uchan-nos/comproc/doc/signal-timing-design/cpu-mem-timing.png

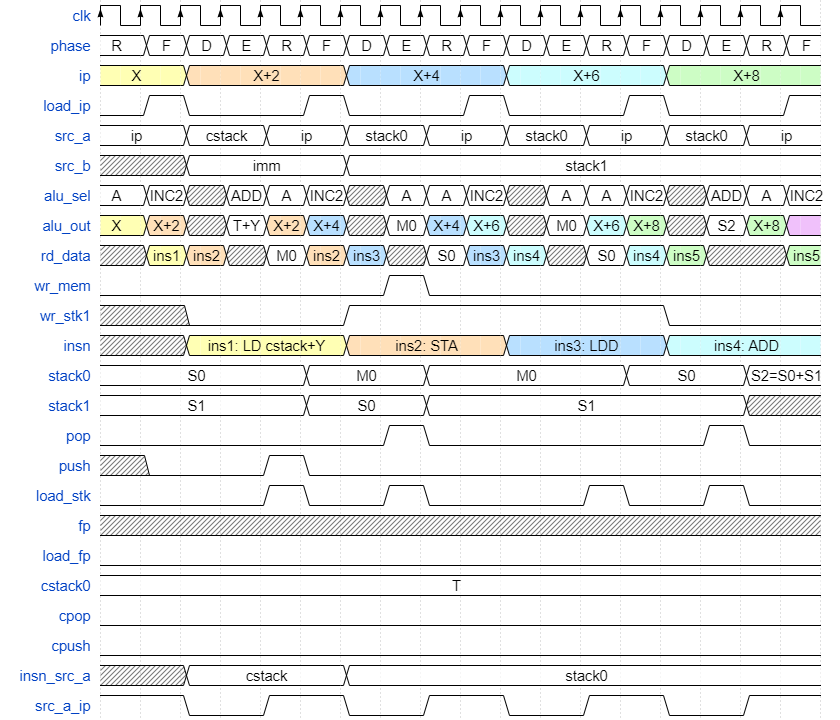
doc/signal-timing-design/cpu-mem-timing.png
