uchan-nos/comproc/doc/signal-timing-design/cpu-mem-timing_isr-int-iret.png

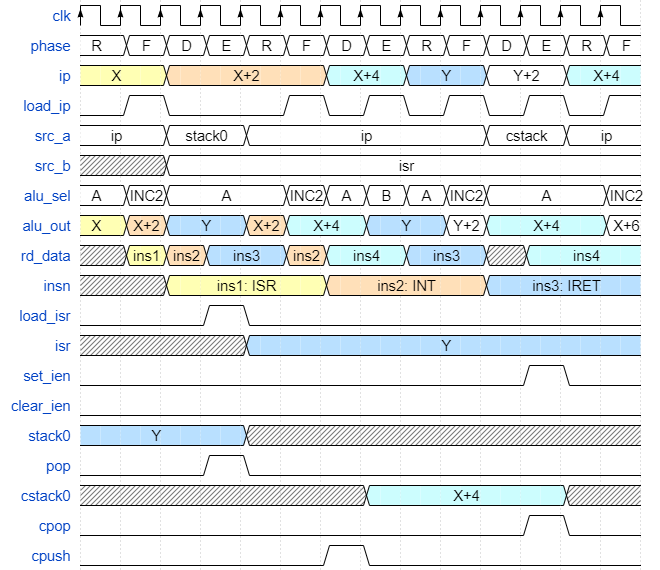
doc/signal-timing-design/cpu-mem-timing_isr-int-iret.png
