uchan-nos/comproc/doc/signal-timing-design/cpu-mem-timing_jmp-call-ret.png

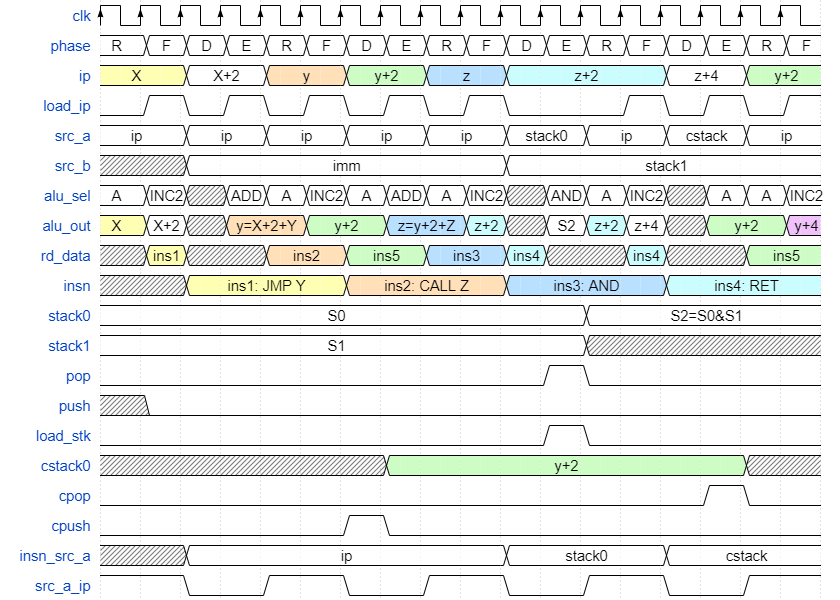
doc/signal-timing-design/cpu-mem-timing_jmp-call-ret.png
