uchan-nos/comproc/doc/signal-timing-design/cpu-mem-timing_jz-fp.png

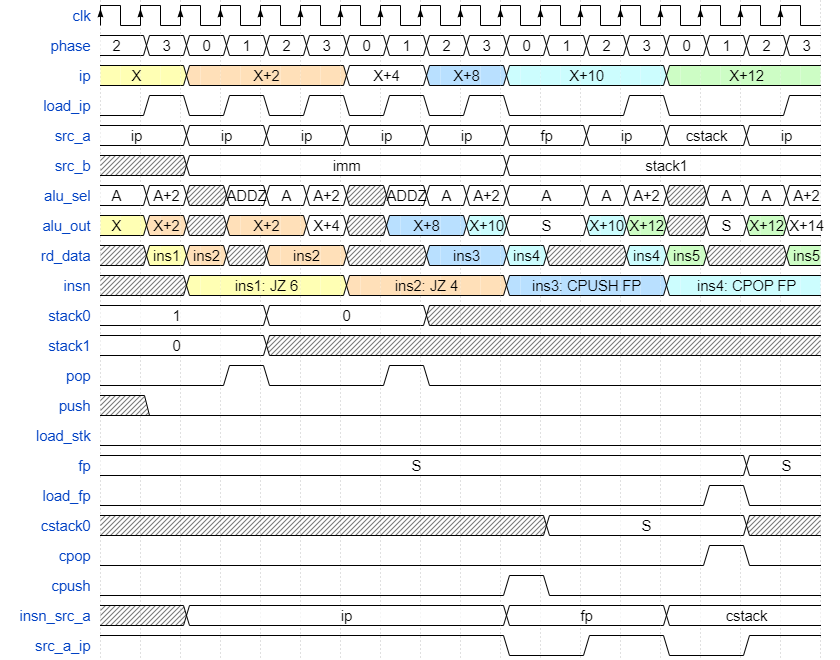
doc/signal-timing-design/cpu-mem-timing_jz-fp.png
