uchan-nos/comproc/doc/signal-timing-design/uart-mux-timing.png

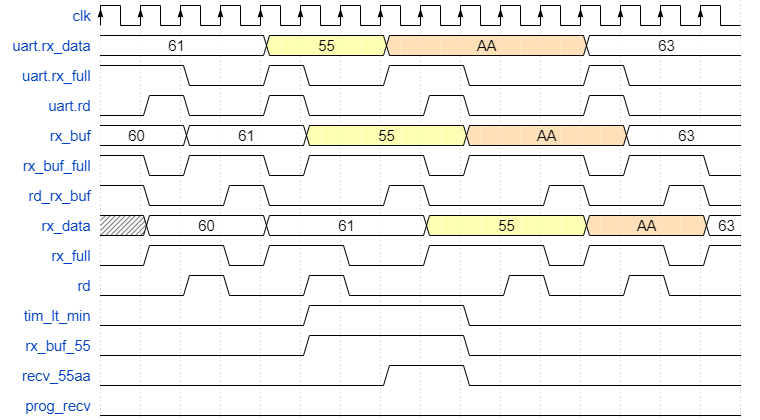
doc/signal-timing-design/uart-mux-timing.png
