uchan-nos/comproc/doc/signal-timing-design/uart-mux-timing_delimiter.png

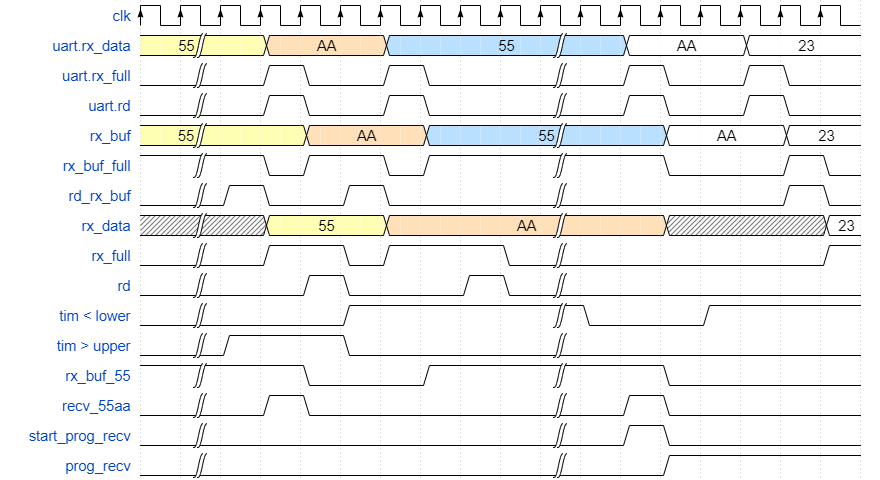
doc/signal-timing-design/uart-mux-timing_delimiter.png
