uchan-nos/comproc/doc/components-relationship.png

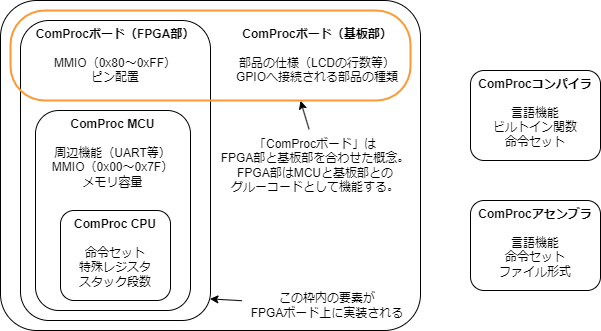
doc/components-relationship.png
