uchan-nos/comproc/doc/schematic/ComProcPC_rev1.pdf

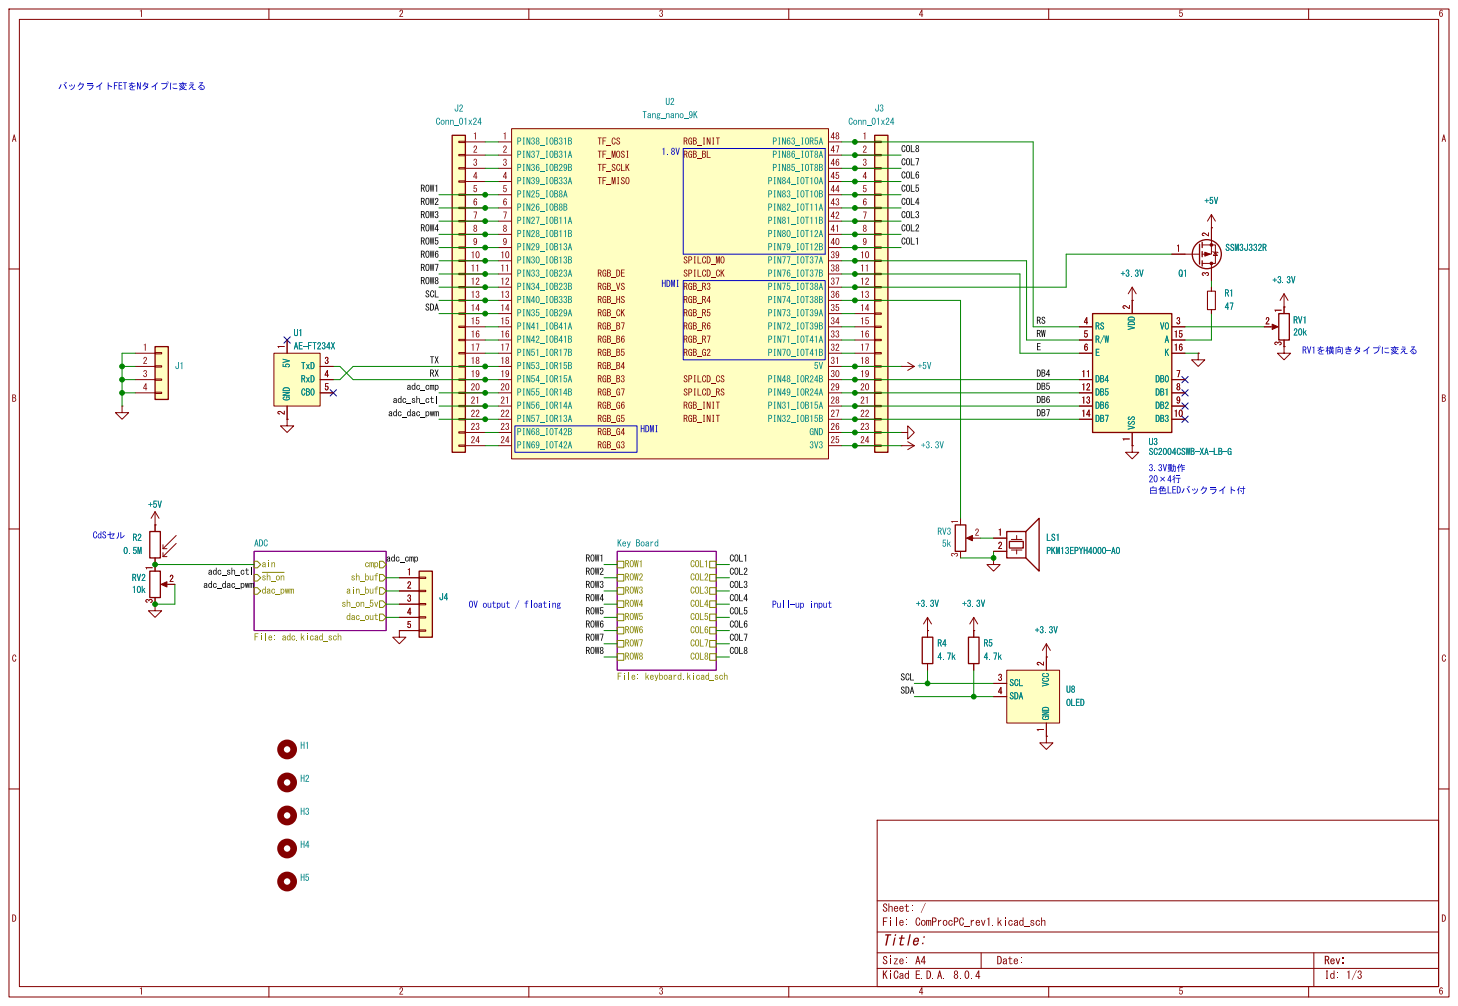
[picture p8: page 1]

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
Id: 1/3 Title: File: ComProcPC_rev1.kicad_sch Sheet: /

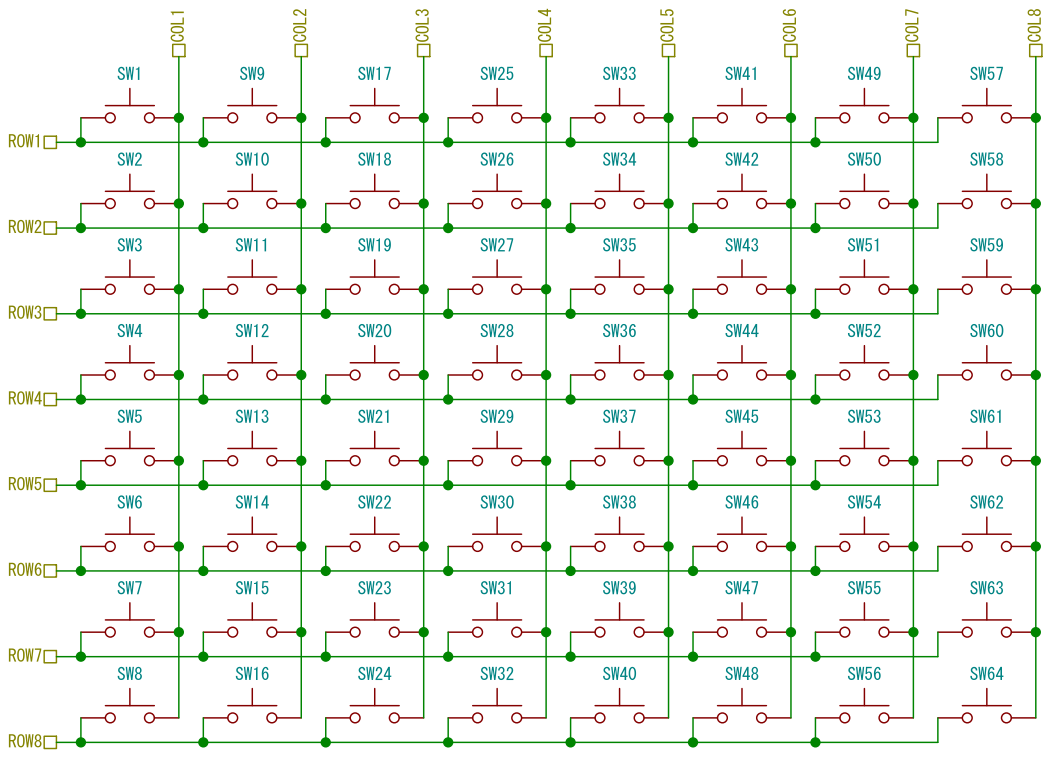
[picture p9: page 2]

Id: 2/3 Title: File: keyboard.kicad_sch Sheet: /Key Board/

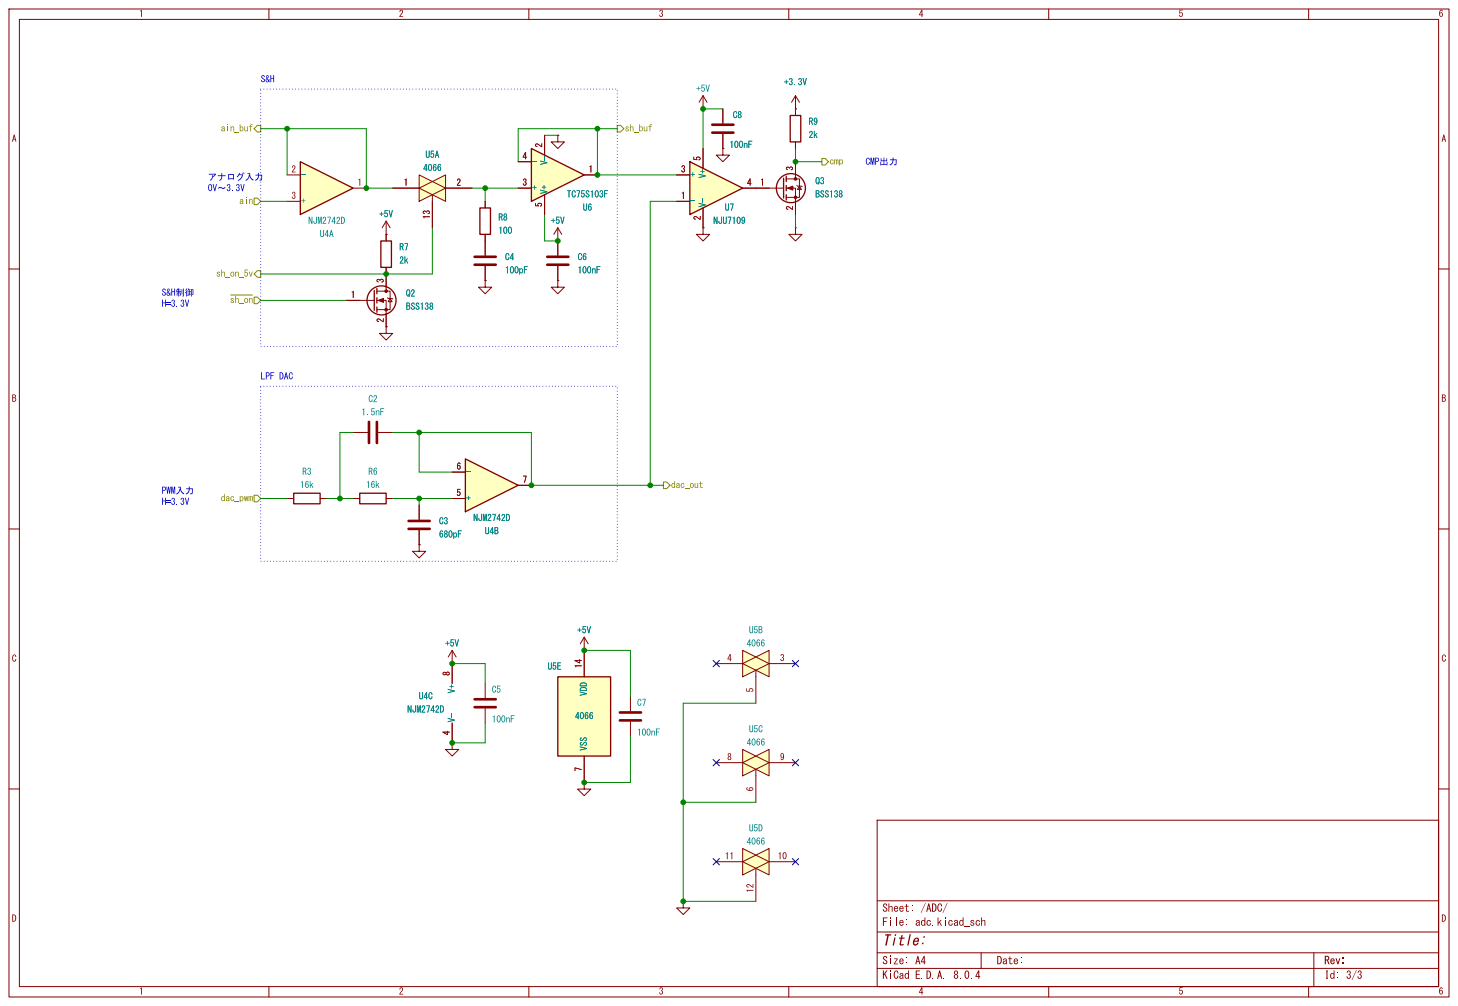
[picture p10: page 3]

Id: 3/3 Title: File: adc.kicad_sch Sheet: /ADC/
