uchan-nos/comproc/doc/schematic/ComProcBoard_rev4.pdf

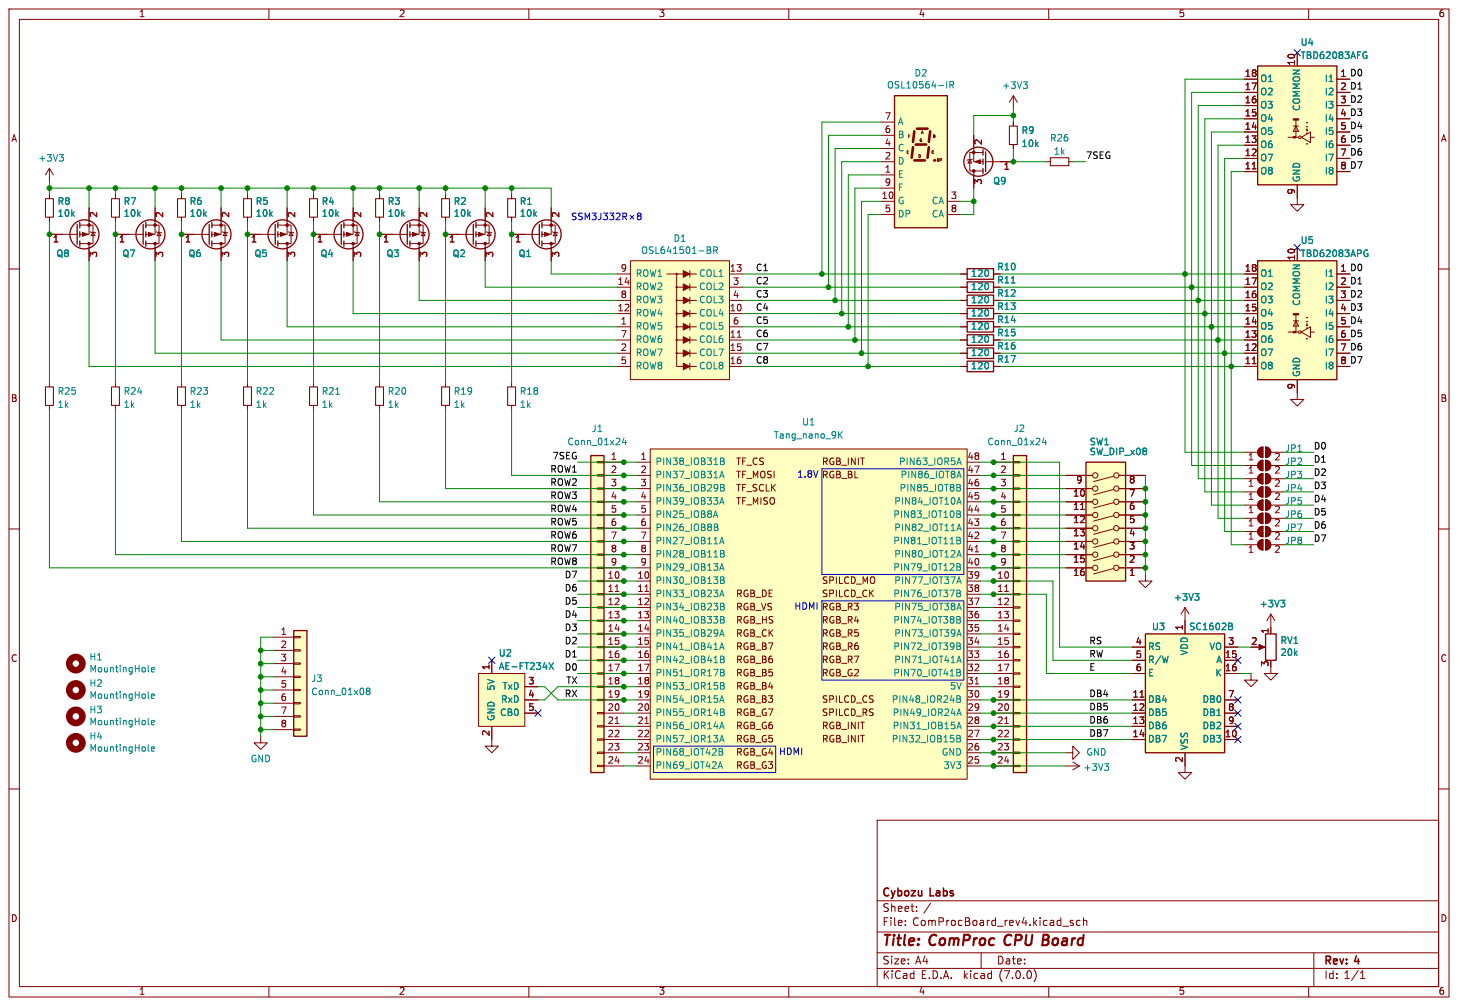
[picture p11: page 1]

Id: 1/1 Title: ComProc CPU Board
