uchan-nos/comproc/doc/datapath/datapath-diagram.pdf

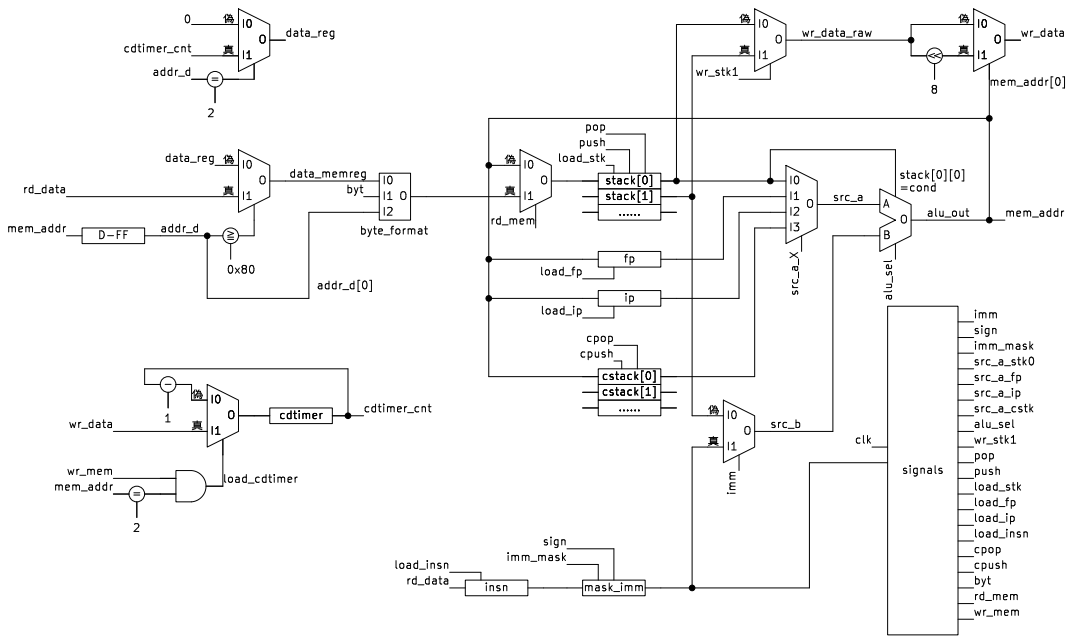
[picture p12: page 1]

cstack[0]
cstack[1]

Id: 1/1 Title: ComProc CPU þÿ0Ç0ü0¿0Ñ0¹ File: datapath-diagram.kicad_sch Sheet: / þÿGit0n0Ö0é0ó0Á main þÿ0k[þ_Ü0Y0‹0Ç0ü0¿0Ñ0¹Vó
