uchan-nos/comproc/doc/datapath/datapath-diagram_2377020c.pdf

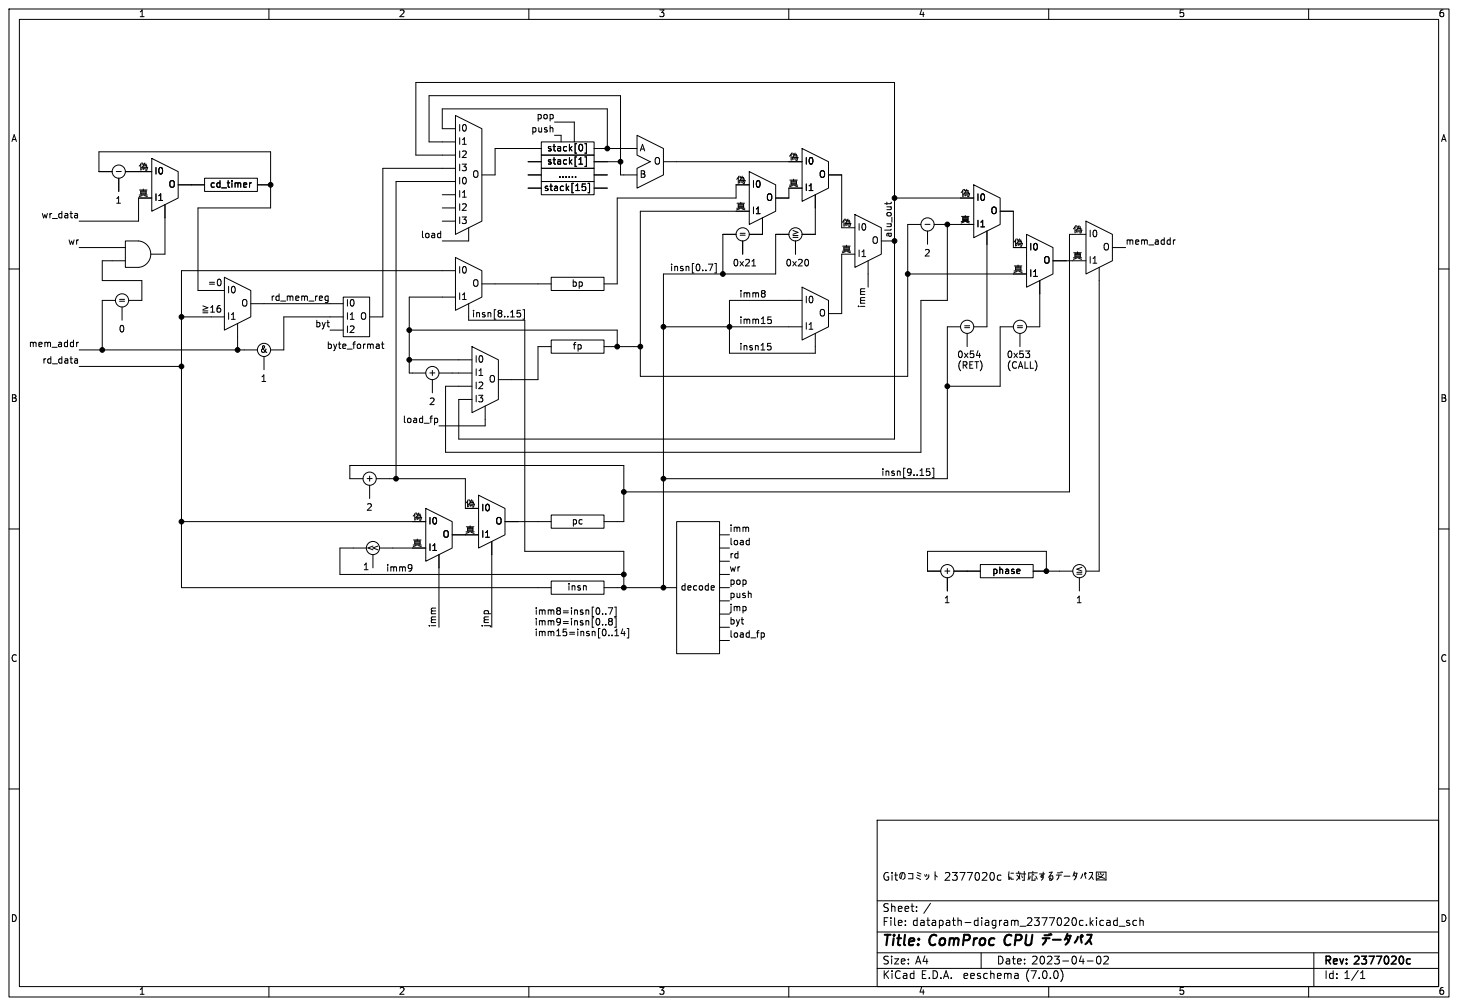
[picture p13: page 1]

stack[0]
stack[1]
