uchan-nos/comproc/doc/schematic/ComProcBoard_rev2.pdf

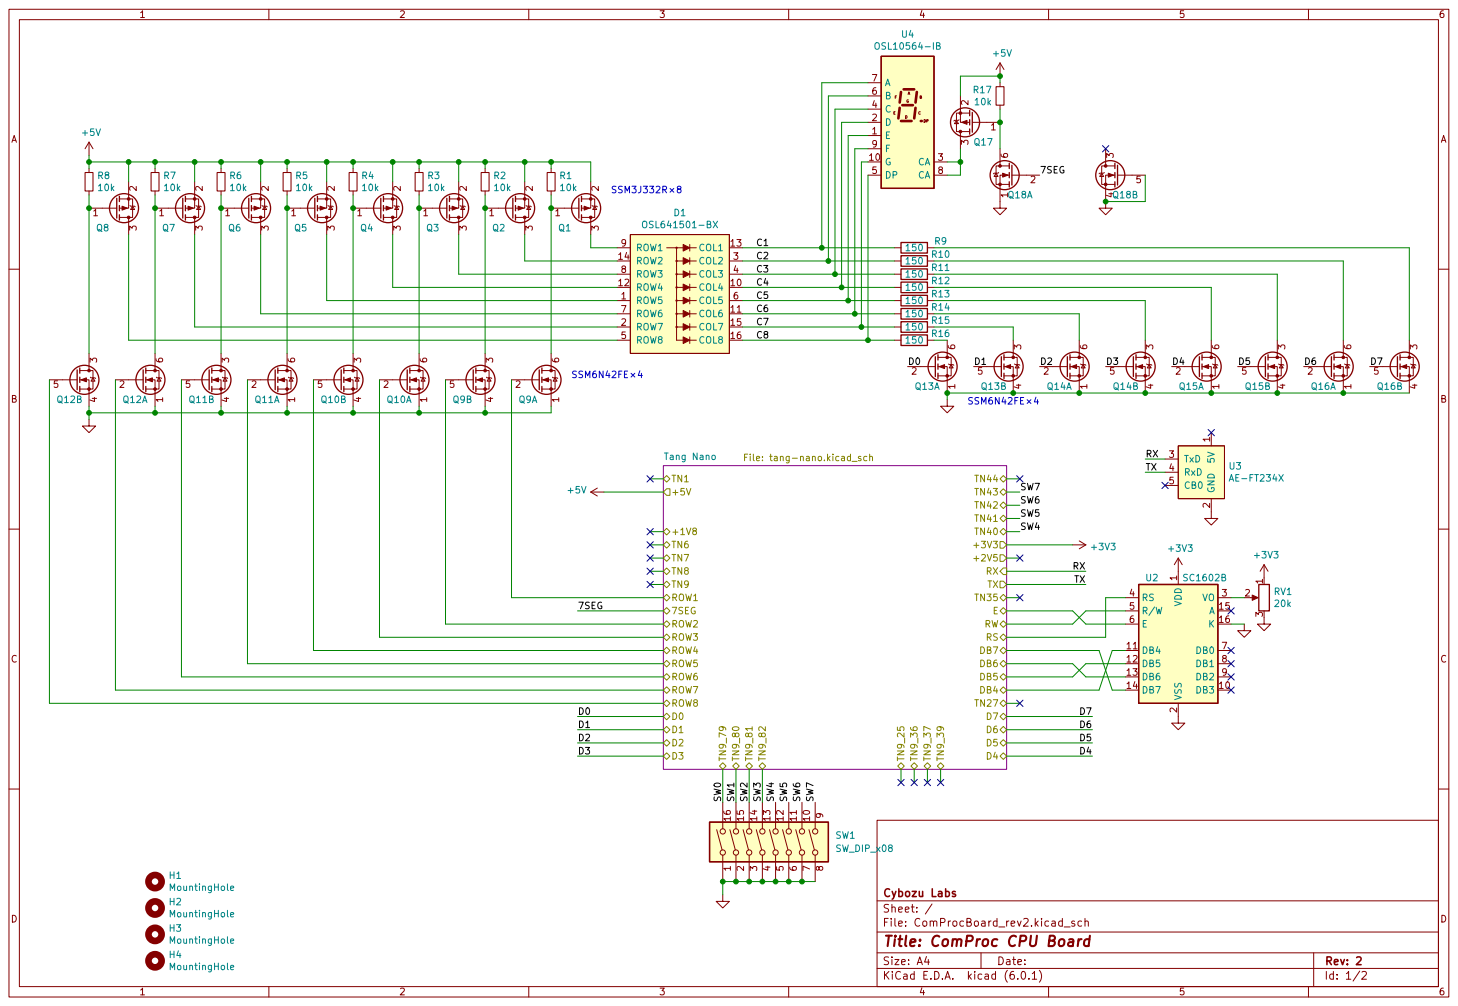
[picture p14: page 1]

Id: 1/2 Title: ComProc CPU Board

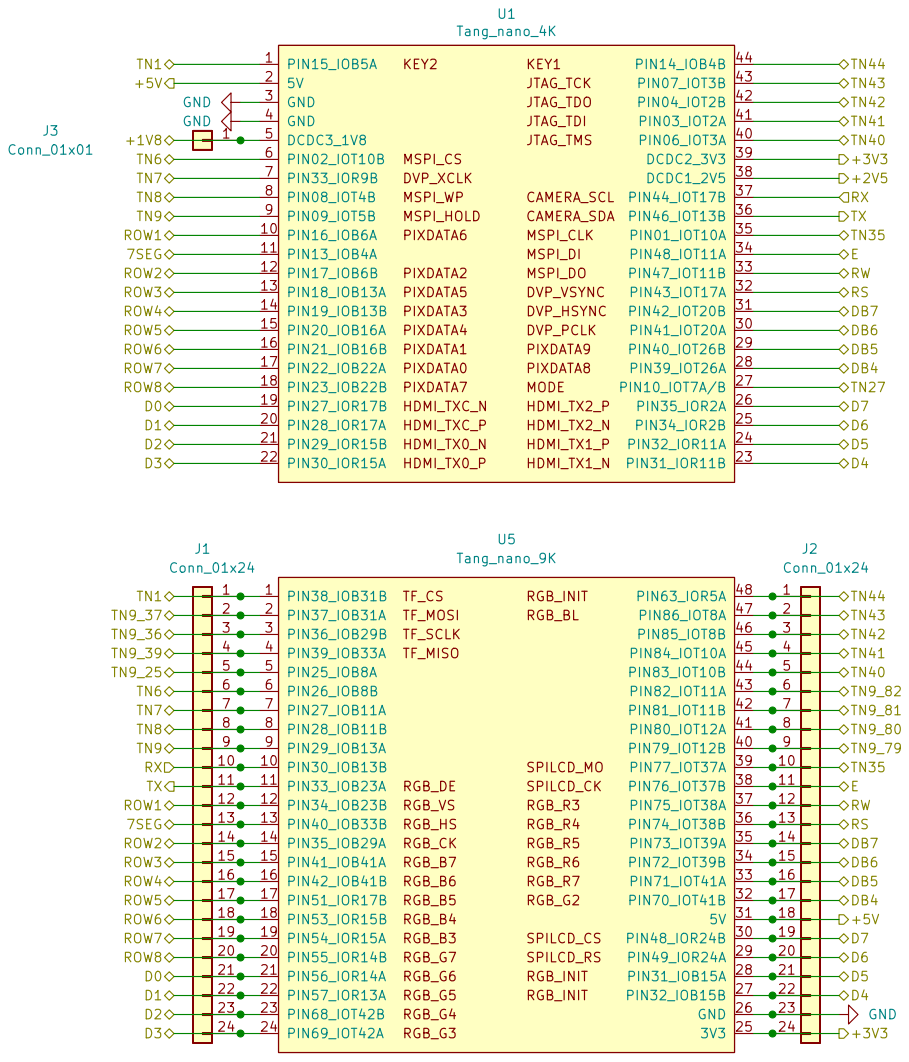
[picture p15: page 2]
