uchan-nos/comproc/doc/datapath/datapath-diagram.kicad_sch

## KiCad design doc/datapath/datapath-diagram.kicad_sch (2023-05-04, an earlier design)

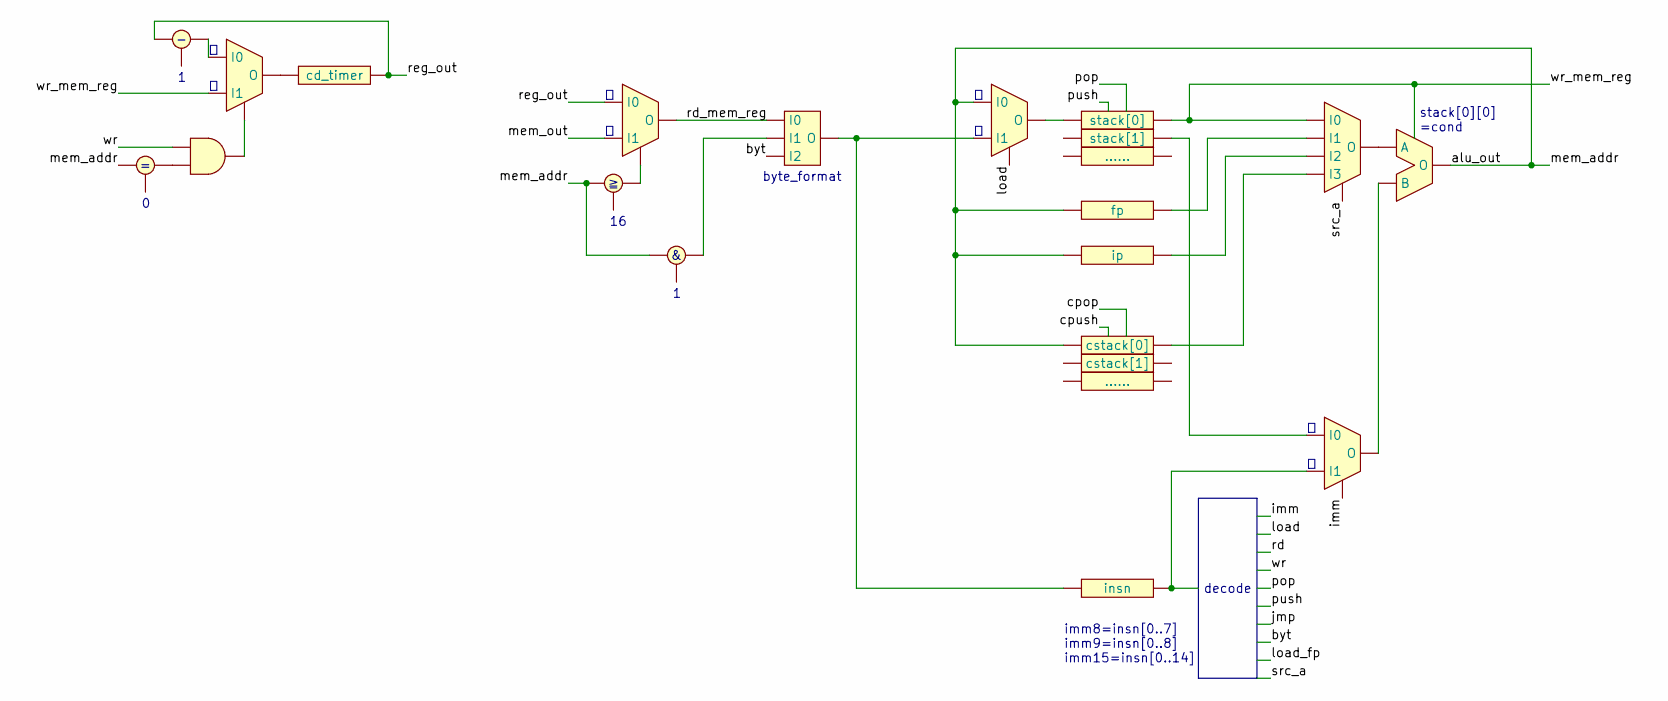
[picture p16: schematic datapath-diagram.kicad_sch]

Parts:
U: fp
U1, U12, U15, U18, U31, U33, U34, U36, U37, U38, U39, U40: (no value)
U4: cstack[0]
U5: cstack[1]
U6, U29: ……
U17: ip
U19: insn
U27: stack[0]
U28: stack[1]
U32: cd_timer

Connections:
unnamed: U1., U31.
unnamed: U4., U40.
unnamed: U12., U15., U40.
unnamed: U15., U19., U28.
unnamed: U17., U40.
unnamed: U18., U19., U27., U34.
unnamed: U32., U36.
unnamed: U33., U34.
unnamed: U36., U37., U39.
unnamed: U38., U39.
unnamed: U., U40.
alu_out: U., U1., U4., U12., U17., U18., U33., U38.
byt: U34.
imm: U15.
load: U18.
mem_out: U31.
rd_mem_reg: U31., U34.
reg_out: U31., U32., U37.
src_a: U40.
wr: U39.
wr_mem_reg: U27., U36., U40.

Notes on the sheet:
decode
byte_format
imm8=insn[0..7] imm9=insn[0..8] imm15=insn[0..14]
stack[0][0] =cond
