uchan-nos/comproc/doc/datapath/datapath-diagram_2377020c.kicad_sch

## KiCad design doc/datapath/datapath-diagram_2377020c.kicad_sch (2023-04-04)

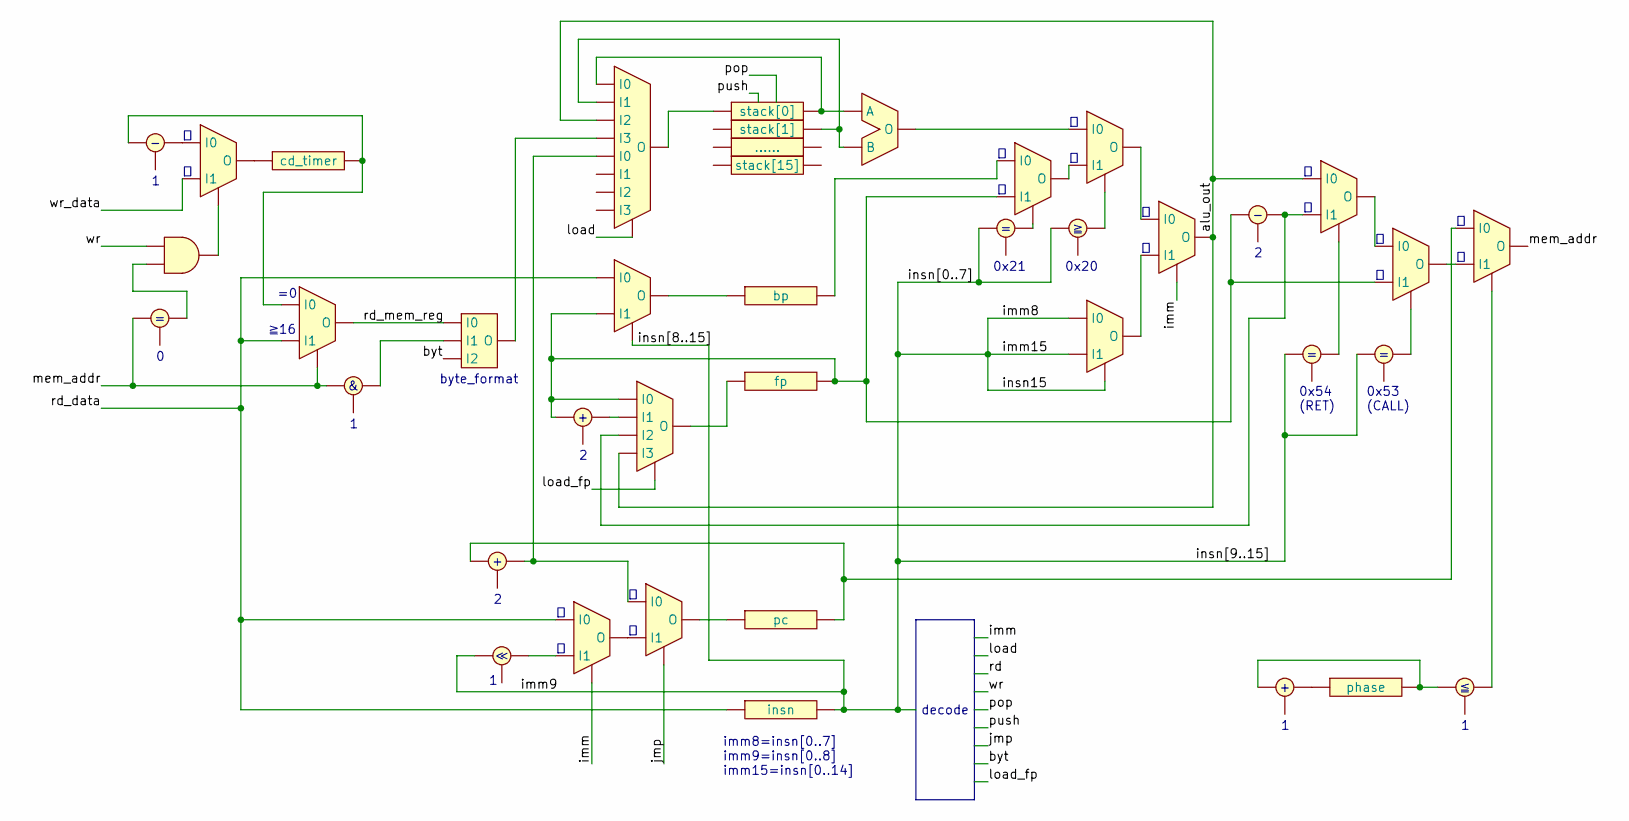
[picture p17: schematic datapath-diagram_2377020c.kicad_sch]

Parts:
U: fp
U1, U2, U3, U4, U5, U6, U7, U8, U9, U10, U11, U12, U13, U14, U15, U16, U21, U22, U23, U24, U25, U26, U31, U33, U34, U35, U36, U37, U38, U39: (no value)
U17: pc
U18: bp
U19: insn
U20: phase
U27: stack[0]
U28: stack[1]
U29: ……
U30: stack[15]
U32: cd_timer

Connections:
unnamed: U1., U2., U3., U17., U23.
unnamed: U2., U20., U35.
unnamed: U3., U4., U5.
unnamed: U5., U6.
unnamed: U8., U9.
unnamed: U8., U10., U11., U12., U13.
unnamed: U12., U26., U27., U28.
unnamed: U13., U14., U18.
unnamed: U15., U16., U17., U23., U26.
unnamed: U16., U21.
unnamed: U18., U22.
unnamed: U20., U35.
unnamed: U5., U7., U24., U25.
unnamed: U26., U27., U34.
unnamed: U31., U32., U37.
unnamed: U32., U36.
unnamed: U33., U34.
unnamed: U36., U37., U39.
unnamed: U38., U39.
unnamed: U., U3., U7., U13., U22., U24., U25.
alu_out: U5., U8., U24., U26.
byt: U34.
imm: U8., U16.
imm15: U4., U6., U9., U11., U14., U19., U21., U22.
jmp: U15.
load: U26.
load_fp: U24.
mem_addr: U1., U31., U33., U38.
rd_data: U16., U19., U22., U31.
rd_mem_reg: U31., U34.
wr: U39.
wr_data: U36.

Notes on the sheet:
decode
byte_format
≧16
0x20
0x54 (RET)
imm8=insn[0..7] imm9=insn[0..8] imm15=insn[0..14]
0x21
0x53 (CALL)
