uchan-nos/comproc/workshop/chap3-addsub/board/rev4_tangnano9k/src/main.sv

module main(
  input sys_clk,
  input rst_n_raw,
  input uart_rx,
  output uart_tx,
  output [7:0] led_col,
  output [8:0] led_row
);

parameter PERIOD = 16'd27000;
parameter GAP = 16'd500;

// logic 定義
logic rst_n;
logic [15:0] counter;
logic [2:0] row_index;
logic [7:0] uart_rx_data, uart_tx_data;
logic uart_tx_en, uart_rx_data_wr;

logic [15:0] recv_data, insn;
logic [9:0] recv_addr, pc;
logic recv_phase, recv_data_v, recv_compl;

logic [7:0] cpu_reg0;
logic cpu_reg0_wr;

// 継続代入
assign led_row = 9'h1ff ^ (led_on(counter) << row_index);
assign led_col = led_pattern(row_index);

always @(posedge sys_clk) begin
  rst_n <= rst_n_raw;
end

// row_index == 0 のときだけ点灯させる
function [7:0] led_pattern(input [2:0] row_index);
  case (row_index)
    3'd0:    led_pattern = 8'b10101010;
    3'd1:    led_pattern = cpu_reg0;
    3'd2:    led_pattern = recv_data[15:8];
    3'd3:    led_pattern = recv_data[7:0];
    default: led_pattern = 8'b00000000;
  endcase
endfunction

// counter を 1ms で 1 周させる
always @(posedge sys_clk, negedge rst_n) begin
  if (!rst_n)
    counter <= 16'd0;
  else if (counter >= PERIOD - 1)
    counter <= 16'd0;
  else
    counter <= counter + 16'd1;
end

// counter が 1 周したら row_index を更新する
always @(posedge sys_clk, negedge rst_n) begin
  if (!rst_n)
    row_index <= 3'd0;
  else if (counter == 0)
    row_index <= row_index + 3'd1;
end

// 隣接する行が光らないように制御する
function led_on(input [15:0] counter);
  led_on = (GAP <= counter) && (counter < PERIOD - GAP);
endfunction

always @(posedge sys_clk, negedge rst_n) begin
  if (!rst_n)
    uart_tx_data <= 8'd0;
  else if (cpu_reg0_wr)
    uart_tx_data <= cpu_reg0;
end

always @(posedge sys_clk, negedge rst_n) begin
  if (!rst_n)
    uart_tx_en <= 1'd0;
  else if (cpu_reg0_wr)
    uart_tx_en <= 1'd1;
  else
    uart_tx_en <= 1'd0;
end

uart uart(
  .*,
  .rx_data(uart_rx_data),
  .rx_data_wr(uart_rx_data_wr),
  .tx_data(uart_tx_data),
  .tx_en(uart_tx_en)
);

/* UART で受信したデータを BRAM に書き込む。

命令長は 16 ビットなので、BRAM も 16 ビット幅で読み書きする。
一方で UART は 8 ビットずつの送受信なので、recv_data に 2 バイト貯める。

信号タイミング図
https://rawgit.com/osamutake/tchart-coffee/master/bin/editor-offline.html

sys_clk      _~_~_~_~_~_~_~_~_~
rx_data_wr   ___~~______~~_____
rx_data      X?==X=H======X=L=====
recv_phase   _____~~~~~~~~_____
recv_data_v  _____________~~___
recv_addr    =N==============X=N+1=
recv_data    =?====X={?,H}======X={H,L}===
*/

// recv_phase は上位バイトを待っているとき 0、下位バイトを待っているとき 1
always @(posedge sys_clk, negedge rst_n) begin
  if (!rst_n)
    recv_phase <= 1'b0;
  else if (uart_rx_data_wr)
    recv_phase <= ~recv_phase;
end

// recv_data は UART から受信した直近 2 バイトを記憶する
always @(posedge sys_clk, negedge rst_n) begin
  if (!rst_n)
    recv_data <= 10'd0;
  else if (uart_rx_data_wr)
    recv_data <= {recv_data[7:0], uart_rx_data};
end

// recv_data_v は命令の受信が完了したら 1 になる
always @(posedge sys_clk, negedge rst_n) begin
  if (!rst_n)
    recv_data_v <= 1'b0;
  else if (uart_rx_data_wr & recv_phase)
    recv_data_v <= 1'b1;
  else
    recv_data_v <= 1'b0;
end

// recv_addr は命令の受信が完了するたびにインクリメントされる
always @(posedge sys_clk, negedge rst_n) begin
  if (!rst_n)
    recv_addr <= 10'd0;
  else if (recv_data_v && ~recv_compl)
    recv_addr <= recv_addr + 10'd1;
end

// FF FF を受け取ったら受信終了と判断
always @(posedge sys_clk, negedge rst_n) begin
  if (!rst_n)
    recv_compl <= 1'b0;
  else if (recv_data_v && recv_data == 16'hffff)
    recv_compl <= 1'b1;
end

// プログラムを格納する BRAM
Gowin_SDPB mem(
  .clka(sys_clk),  //input clka
  .cea(~recv_compl),      //input cea
  .reseta(!rst_n), //input reseta
  .clkb(sys_clk),  //input clkb
  .ceb(1'b1),      //input ceb
  .resetb(!rst_n), //input resetb
  .oce(1'b0),      //input oce
  .ada(recv_addr), //input [9:0] ada
  .din(recv_data), //input [15:0] din
  .adb(pc),        //input [9:0] adb
  .dout(insn)      //output [15:0] dout
);

// 自作 CPU を接続する
cpu cpu(
  .rst(~rst_n | ~recv_compl),
  .clk(sys_clk),
  .insn(insn),
  .reg0(cpu_reg0),
  .reg0_wr(cpu_reg0_wr)
);

// recv_compl が 1 になったらプログラムの実行を進める
always @(posedge sys_clk, negedge rst_n) begin
  if (!rst_n)
    pc <= 10'd0;
  else if (recv_compl && pc < recv_addr)
    pc <= pc + 10'd1;
end

endmodule
