uchan-nos/comproc/workshop/chap3-addsub/board/rev4_tangnano9k/src/gowin_sdpb/gowin_sdpb.v

//Copyright (C)2014-2022 Gowin Semiconductor Corporation.
//All rights reserved.
//File Title: IP file
//GOWIN Version: V1.9.8.03
//Part Number: GW1NSR-LV4CQN48PC7/I6
//Device: GW1NSR-4C
//Created Time: Fri Feb 25 11:54:53 2022

module Gowin_SDPB (dout, clka, cea, reseta, clkb, ceb, resetb, oce, ada, din, adb);

output [15:0] dout;
input clka;
input cea;
input reseta;
input clkb;
input ceb;
input resetb;
input oce;
input [9:0] ada;
input [15:0] din;
input [9:0] adb;

wire [15:0] sdpb_inst_0_dout_w;
wire gw_vcc;
wire gw_gnd;

assign gw_vcc = 1'b1;
assign gw_gnd = 1'b0;

SDPB sdpb_inst_0 (
    .DO({sdpb_inst_0_dout_w[15:0],dout[15:0]}),
    .CLKA(clka),
    .CEA(cea),
    .RESETA(reseta),
    .CLKB(clkb),
    .CEB(ceb),
    .RESETB(resetb),
    .OCE(oce),
    .BLKSELA({gw_gnd,gw_gnd,gw_gnd}),
    .BLKSELB({gw_gnd,gw_gnd,gw_gnd}),
    .ADA({ada[9:0],gw_gnd,gw_gnd,gw_vcc,gw_vcc}),
    .DI({gw_gnd,gw_gnd,gw_gnd,gw_gnd,gw_gnd,gw_gnd,gw_gnd,gw_gnd,gw_gnd,gw_gnd,gw_gnd,gw_gnd,gw_gnd,gw_gnd,gw_gnd,gw_gnd,din[15:0]}),
    .ADB({adb[9:0],gw_gnd,gw_gnd,gw_gnd,gw_gnd})
);

defparam sdpb_inst_0.READ_MODE = 1'b0;
defparam sdpb_inst_0.BIT_WIDTH_0 = 16;
defparam sdpb_inst_0.BIT_WIDTH_1 = 16;
defparam sdpb_inst_0.BLK_SEL_0 = 3'b000;
defparam sdpb_inst_0.BLK_SEL_1 = 3'b000;
defparam sdpb_inst_0.RESET_MODE = "SYNC";

endmodule //Gowin_SDPB
