uchan-nos/comproc/src/examples/stepping-motor.c

#include "mmio.h"
#include "delay.h"
#include "lcd.h"

void out(char val, int ms) {
  if (ms <= 4) {
    gpio = led_port = val;
    delay_ms(ms);
    return;
  }

  for (; ms > 0; ms -= 4) {
    gpio = led_port = val;
    delay_ms(2);
    gpio = led_port = 0;
    delay_ms(2);
  }
}

int main() {
  int i;
  int j;
  int d = 4;
  for (j = 0; j < 8; j++) {
    for (i = 0; i < 64; i++) {
      out(0x05, d);
      out(0x06, d);
      out(0x0a, d);
      out(0x09, d);
    }
    out(0x09, d * 256);
  }
  gpio = 0;
  return 0;
}
