uchan-nos/comproc/(commit log)

2022-02-10 空の Gowin プロジェクト
2022-02-14 LED 点灯のサンプルコード
2022-02-14 意味の無いイベントを除去
    rst_n はどっちみち sys_clk に同期して変化するので negedge rst_n は不要
2022-02-14 コメント修正
2022-02-14 .gitignore を上位の階層に移動
2022-02-14 ダイナミック点灯のサンプル
2022-02-16 ext_clk を廃止し sys_clk に統一
2022-02-17 LED 点灯のデッドタイムを生成
2022-02-17 できるだけ組み合わせ回路を生成する
2022-02-17 GAO 設定ファイルを追加
2022-02-17 リセットボタンの遅延をなるべく低減
2022-02-21 chap1をコピーしてUART受信を追加
2022-02-21 UART受信ロジックを最適化
2022-02-21 信号名を変更
2022-02-21 chap2 を chap2-echo にコピー
2022-02-21 UARTエコーバック
2022-02-22 シリアル通信ツールを追加
2022-02-24 最初のコンパイラ
2022-02-24 エコーバック回路のシミュレーションコードを追加
2022-02-24 紛らわしいコメントを削除
2022-02-28 chap2-echo を chap3 にコピー
2022-03-01 レジスタ代入と出力命令を分離
2022-03-02 コンパイラを出力命令の分割に対応
2022-03-02 chap3 を chap3-addsub にコピー
2022-03-03 chap3 の CPU シミュレーションテストを改良
2022-03-03 uart.pyに2バイトずつ渡せるようにする
2022-03-03 ADD 命令を追加
2022-03-03 減算をサポート
2022-03-03 複数の加減算の列に対応
2022-03-03 chap3-addsub を chap4 へコピー
2022-03-03 コンパイラを +, -, * の演算に対応させる
2022-03-03 CPU をスタックマシンに改造し乗算に対応
2022-03-03 不要な変数を削除
2022-03-09 chap4 を src にコピー
2022-03-09 board を cpu 以下に移動
2022-03-09 エンドツーエンドテストを追加
2022-03-09 プログラムの繰り返し受信に対応
2022-03-09 scanf の代わりに自作トークナイザを使う
2022-03-10 return文を出力命令に対応させる
2022-03-10 'int'と任意の識別子の字句解析に対応
2022-03-16 1文字変数へ対応
2022-03-16 実機でプログラムが連続実行できないバグを修正
2022-03-16 実機での変数読み書きに対応
2022-03-16 実機変数サポートに必要なファイルを追加
2022-03-16 Tang Nano 9K に移植、UART の入出力により動作確認
    LED 関係はボード未作成のため動作未確認
2022-03-31 Tang Nano 9K 向けに外部 UART と LED のポートを修正
2022-03-31 数式の括弧()をサポート
2022-04-01 変数の代入に対応
2022-04-05 機械語の体系を制御線ベースに改造
2022-04-05 アセンブラを導入、機械語の改良
2022-04-06 コンパイラのエラー報告をリッチに
2022-04-06 比較演算子 <, > のサポート
2022-04-06 アセンブラのコードを追加し忘れていたので追加
2022-04-06 演算子の優先順位のバグを修正
2022-04-06 if文サポート（WIP）
2022-04-11 if 文サポート（WIP）、アセンブラバックパッチ
2022-04-13 if文サポート
2022-04-14 機械語をデコードして制御線に流す
2022-04-14 無条件ジャンプに対応
2022-04-14 リファクタ
2022-04-18 複合代入とインクリメントに対応
2022-04-19 for文サポート、jmpバグ修正
2022-04-20 プログラムをゆっくり実行する機能を追加
2022-04-21 intを16ビットに拡大
2022-04-22 ==のサポート、charのサポート
2022-04-22 ポインタのサポート
2022-04-22 Rev.1ボードでint型の16ビット化に対応
2022-04-26 アセンブラが吐く機械語を大文字に
2022-04-26 CPUボードRev.2に対応
2022-04-27 CPUボードRev.2の回路図を追加
2022-04-27 ボード Rev.2 の LED の隣接行対策
2022-04-27 ダイナミック点灯を全行やる
2022-04-27 ワークショップ用ファイルを Rev.2 に対応
2022-05-13 小さい整数に対するpushを効率化
2022-05-13 論理演算子 &&,|| を追加
2022-05-16 char 型のサポート
2022-05-16 文字リテラルをサポート
2022-05-17 文字列リテラルのサポート（WIP）
2022-05-19 バックパッチのバグ修正
2022-05-31 命令メモリとデータメモリを統合
2022-06-01 PUSH を 15 ビット値対応に拡張
2022-06-01 PUSH が 11 ビットしか受け付けないバグを修正
    [main.c]
2022-06-01 8ビットを超えるアドレスのバックパッチを修正
2022-06-02 文字列リテラルサポート
    rev1_tangnano4k は未サポート
2022-06-02 添え字演算子 [] のサポート
2022-06-02 whileとbreakに対応
2022-06-03 多重 for 文に対応
2022-06-03 変数初期化忘れを修正
2022-06-03 複数のif文があるときの不具合を修正
2022-06-06 UART からのデータ読み込みに対応
2022-06-06 シミュレーション実行のバグを修正
2022-06-06 負の整数リテラルのサポート
2022-06-07 LT 命令を符号付き判定に変更
    UART 入力の仕様を少し修正（-1 も正しく送信する足がかり）
    [main.sv]
2022-06-07 uart.pyに結果を待たないモードを追加
2022-06-07 ビット演算 | ^ ~ を追加
2022-06-07 continue文をサポート
2022-06-07 配列の定義と使用を一部サポート
2022-06-08 配列アクセスをサポート
2022-06-08 変数サイズの決定ロジックの配列対応
2022-06-08 複数バイトのUART入力にシミュレーションを対応したい（WIP）
2022-06-08 複数バイトのUART入力をシミュレーションする
2022-06-08 ビットシフトをサポート
2022-06-10 演算子の優先順位のバグ修正
    シミュレーションでもバグが発現するようにした
2022-06-13 標準出力のテストを追加
2022-06-20 インクリメント演算にも型を付ける
2022-06-22 CPU が標準出力に対応
2022-06-22 main関数の定義をサポート
2022-06-24 関数定義と呼び出しのサポート
2022-06-30 引数付き関数の実行をサポート
    関数実行に際しスタックフレームを作成
2022-06-30 再帰関数のテストを追加
2022-06-30 UART 通信速度を 115.2kbps に向上
2022-07-04 専用コールスタックを廃止しメインメモリに統合
2022-07-04 論理合成できないバグを修正
2023-03-31 attach_vcom.sh に ID を明示したときだけ接続するようにする
    無引数で実行すると、シリアル変換デバイスを一覧表示するだけで処理を終える
2023-03-31 メモリマップを変更
    CPU 外の周辺機器を 010h - 01fh へ配置
2023-03-31 CPUにタイマー機能を追加し、1ms単位の時間待ちを可能にする
2023-03-31 LEDにアクセスするメモリマップトIOを追加
2023-03-31 実機でもタイムアウトするように調整
2023-03-31 実機で奇数アドレスへのバイトアクセス対応
2023-03-31 LCD表示器SC1602を操作するサンプルコードを追加
2023-03-31 関数を呼び出すとローカル変数が壊れるバグを修正
2023-03-31 LCD表示をアセンブラで最適化したサンプルを追加
2023-04-04 コミット 2377020c に対するデータパス図を追加
    [datapath-diagram_2377020c.kicad_sch]
2023-04-07 新しいCPUのデータパス・タイミング設計のドキュメントを追加
    CPUのコードはまだ修正していない。
    今後、設計に合わせて修正予定。
    [datapath-diagram.kicad_pcb, datapath-diagram.kicad_sch]
2023-04-10 LED 点滅のサンプルプログラムを追加
2023-04-11 コンパイラの出力をインデントする
2023-04-23 Rev.2用ファイル群をRev.4へコピー
2023-04-23 Rev.4基板のピン配置に合わせて修正
2023-04-23 ファイルの拡張子を判別して適切にビルドを行う
2023-04-24 DB命令のバグを修正
    00343ce04f05432f732a7481e4eb857d13ea68e8 で導入されたバグを解消
2023-04-24 新しい ISA に従って命令リストを更新
2023-04-24 アドレスマップ（ドキュメント）を修正
    [datapath-diagram.kicad_sch]
2023-04-24 データパス図を更新
    メモリへ書き込むデータをstack[0]/stack[1]から選べるようにする
    [datapath-diagram.kicad_sch]
2023-04-24 即値の符号有無を明記 uimm/simm
2023-04-24 即値付き命令のアドレッシングを微修正
    絶対アドレスを指定できるようにする
2023-04-24 データパス図の信号名を現行の名前に合わせる
    [datapath-diagram.kicad_sch]
2023-04-24 アドレスビット幅を12ビットに拡張
2023-04-24 汎用のスタック実装とテストを追加
2023-04-25 ALU実装とテストを追加
2023-04-26 デコーダ実装とテストを追加 (WIP)
2023-04-26 スタックに load 信号を追加
2023-04-27 コードフォーマットを整える
2023-04-27 スタックのload信号をデコーダのテストに追加
2023-04-27 デコーダのテストにLDDのテストを追加
2023-04-27 テストケースの load の期待値を修正
2023-04-29 即値無し命令の機械語割り当て直し
2023-04-29 デコーダの実装とテスト
2023-04-29 デコーダに cpop と cpush を追加
    [datapath-diagram.kicad_sch]
2023-05-02 クロックからフェーズ信号を作り出すsignalizerを実装
2023-05-02 機械語の最上位ビットの0/1を交換
    即値無し命令を16進数で表したときにFxxxという良くない表記になるのを避ける
2023-05-02 デコーダのテーブルを4ビットから16ビットに拡張
    可読性、メンテナンス性の向上が目的
2023-05-02 各種信号線生成のテストケースを追加
2023-05-02 信号線生成器を一通り実装
2023-05-02 ALUにADDZとADDNZを追加
2023-05-02 test_modulesコマンドを追加
2023-05-02 テストケースをスリム化
2023-05-02 ST命令のテスト追加と信号修正
2023-05-02 POP, NOT, LDD.1 のテストを追加、信号修正
2023-05-02 RET のテストを追加
2023-05-02 クロック分周器を追加
2023-05-02 スタックにstack[1]を取り出す信号を追加
2023-05-02 カウントダウンタイマのモジュールを追加、テスト改良
2023-05-03 signals に load_insn 信号を追加
2023-05-03 デコーダのバグ修正
    X=0のとき、ALUをADDではなくBとする
2023-05-03 test_module.shを追加
2023-05-03 CPUを新しいISAに合わせて再実装
    [datapath-diagram.kicad_sch]
2023-05-03 コードコメントとデータパス図を修正
    [datapath-diagram.kicad_sch]
2023-05-03 ALU機能マクロを使ってリファクタ
2023-05-03 Rev4ボードを新ISAに対応
2023-05-03 Rev2&3ボードを新ISAに対応
2023-05-03 CPUシミュレータで動作可能にする
2023-05-03 ドットマトリクスLEDの列番号を逆順に修正
2023-05-03 新ISA用にメモリマップトIOのアドレスを修正
2023-05-03 LD imm, ST imm の最下位ビットを有効活用する
2023-05-03 アセンブラを新ISAに対応
2023-05-03 コンパイラを新ISAに対応
2023-05-03 符号付き即値の符号拡張を実装
2023-05-03 コンパイラとアセンブラのバグ修正
2023-05-03 新ISAに合わせてテストケースのアドレスを修正
2023-05-03 コンパイラとアセンブラのバグを修正
2023-05-03 新ISAを実装したCPUでE2Eテストを全部通過するように修正
2023-05-04 データパス図を現状に合わせて更新
    [datapath-diagram.kicad_sch]
2023-05-04 CPU回路を単純化
2023-05-04 Place & Route レポートファイルを追加
2023-05-04 E2Eテストが動くようにRev2&4ボードのプログラムを修正
2023-05-04 アセンブラが対応するプログラムサイズを増加
    CPUが搭載するRAMの最大量まで増やす
2023-05-04 新ISA用にサンプルプログラムを更新
2023-05-12 ASTノードの木構造印字機能を追加
2023-05-13 sim.svにCPU信号をダンプする機能を追加
2023-05-13 信号タイミング図を一部修正
2023-05-23 ビルド結果のアセンブリコードと機械語を表示する
2023-05-23 タイミング図を更新
2023-05-26 ワークショップ用サンプルコード準備のためのスクリプトを追加
    - copy-board.sh: chapN/board/proj をコピーする
    - adjust2to4.sh: コピーした Rev.2 用コードを Rev.4 用に調整する
2023-05-26 rev2_tangnano9k を rev4_tangnano9k にコピー
    コピーしただけで、Rev.4 用の変更はまだ加えていない
2023-05-26 chapN/board/rev4_tangnano9k を Rev.4 に対応
2023-05-26 動かなくなっていたテストスクリプトを除去
2023-05-26 戻り値が void な関数の定義をサポート
2023-05-26 AST 印字機能をコマンドライン引数で ON/OFF する
2023-05-26 値を返す必要の無い関数を void 化
2023-05-26 アセンブラをコメント（; or #）に対応
2023-05-26 命令をいったん貯める方式がテスト通過
2023-05-26 fpの調整を一回で済ませる
2023-05-26 ローカル変数が存在しない場合に add fp 命令を出力しない
2023-05-26 LD.1, ST.1 を追加
2023-05-29 voidをサポートする WIP
2023-05-29 コンパイラ単体のテストを追加
2023-05-30 命令を即時に出力せず、いったん配列に貯める WIP
2023-05-31 テストケースで ldd が登場するように修正
2023-05-31 push x+n; ldd を ld x+n にまとめる
2023-05-31 スタックを綺麗に保つ pop を発行しない
2023-06-02 最適化をなるべく早い段階で行う
    コード生成後の命令列に対し最適化するのではなく、
    コード生成時に最適なコードを生成する。
    その方が情報量が多く、正しい最適化が行える。
2023-06-02 WIP: LD.1, ST.1 の即値アドレッシング版を追加する
2023-06-07 アセンブラを即値付き LD.1, ST.1 に対応
2023-06-07 コンパイラを LD.1/ST.1 に対応
2023-06-18 CPUボードRev.4の回路図を追加
2023-07-28 HTTP サーバでトレース画面を表示する
2023-07-31 CPUシミュレーションにトレース情報出力機能を追加
2023-08-01 ビジュアライザの実装を開始
2023-08-01 フレーム毎にSVGファイルを描画
2023-08-01 src/cpu/visualizer から src/visualizer に移動
2023-08-01 フレーム操作の HTML ページを追加
2023-08-02 アセンブラを入力してシミュレーション
2023-08-02 不必要な最適化を削除
2023-08-02 フレーム番号を表示＆番号書き換えによるジャンプ
2023-08-02 GET vis.html でも機械語を表示する
2023-08-03 SVG の左側に情報表示
2023-08-03 レジスタを箱型で表示
2023-08-03 MUX やバスの信号値を追加
2023-08-03 ALUからの戻りパスを追加
2023-08-04 シミュレーションの命令名デコーダのバグを修正
2023-08-04 src_a_sel の値を記載
2023-08-04 アセンブラのst.1とld.1のバグを修正
2023-08-04 命令名を表示
2023-08-08 uart.py のデフォルトに実在するポートを指定する
2023-08-08 uart.pyにファイルから値を読む機能を追加
2023-08-17 byte_format を追加
2023-08-18 コンパイラの出力にASTノード情報を付与
2023-08-18 AST 表示時にノードインデックスを追加で表示
2023-08-18 リファクタリング
2023-08-18 コンパイラに入出力ファイル名を指定するようにする
2023-08-30 異なる関数に同名の変数がある場合のバグを修正
2023-08-30 ブロックによるスコープ形成に対応
2023-09-01 コンパイラの引数変更に追従
2023-09-01 アセンブラにソフトウェア割り込み命令を追加
    - コンパイラに asm() 記法を追加
    - アセンブラに int 命令を追加
    CPU 自体はまだ割り込みに対応していない
2023-09-01 CPUに割り込み命令intを付け足す WIP
2023-09-01 CPUに割り込み命令int, isrを付け足す
2023-09-01 インラインアセンブラをインデントする
2023-09-01 連続する文字列リテラルを結合して扱う
2023-09-01 割込ハンドラの位置をラベルで指定する
2023-09-01 ビジュアライザが自動生成するファイルを gitignore
2023-09-01 カウントダウンタイマの割り込みフラグを読み取り可能に
2023-09-01 外部割り込みに対応
2023-09-01 テスト用スクリプトを拡充
2023-09-01 LCD制御サンプルのバグ修正
2023-09-01 キャスト式をサポート
2023-09-05 グローバル変数のサポート
2023-09-05 __attribute__(()) 記法に対応
2023-09-05 コードサンプルを改良
    グローバル変数のアドレス固定配置機能を使って可読性を向上
2023-09-06 if や for などが複文以外を取れるようにする
2023-09-06 比較演算 <= と >= をサポート
2023-09-06 プログラム終了を ffff から 7fff に変更
2023-09-08 UARTモジュールで割り込みをサポート WIP
2023-09-08 現行の UART モジュールの信号タイミングを図示
2023-09-15 自作 UART モジュールを CPU に内蔵（WIP）
2023-09-18 ビルドエラーを解消
2023-09-19 モジュールのポート指定に関するバグ修正
2023-09-19 CPU をゆっくり動作させる機能を追加
2023-09-19 プログラムが実行されないバグを修正
2023-09-19 CPU ゆっくり動かすモードのバグ修正
    少し表示を変えると謎の挙動が発生する問題が残っている
2023-09-25 いろいろなパターンで LED 出力を実験
2023-09-25 追加のパターン計測
2023-09-25 UART受信フィルタを追加
    謎現象が収まったかもしれない
2023-09-26 メモリ読み込みタイミングのバグを修正
2023-09-26 UART の制御ワードをソフトから読み取れるようにする
2023-09-26 BRAMにsys_clkを供給
    謎の現象が収まったかも
2023-09-26 LED 0,1行目に insn を表示
2023-09-28 ソフトウェア割り込みのタイミング図を追加
2023-10-04 UART のアドレス変更（82 to 06）に合わせ、各部を修正
    [main.c]
2023-10-04 LED 点灯パターンのコメントを削除
2023-10-04 LED に UART 受信データを過去 3 命令分表示
2023-10-04 UART受信タイミングをPIN55に出力
2023-10-04 UART 連続受信時の安定性向上
2023-10-04 クロック制約を追加
2023-10-05 sim.sv のビルドエラーを解消
2023-10-05 シミュレーションが正常に実行されるよう修正
2023-10-06 テストケースの詳細実行用スクリプトを改良
2023-10-09 シミュレーションでUART信号生成
2023-10-10 シミュレーションでUART信号を生成（途中）
2023-10-10 UART 系シミュレーションテストが動作
2023-10-12 ユニットテストがビルドできるように修正
    ビルドできるが、失敗するテストは残っている
2023-10-12 cpu.rd_mem の意味を変更（WIP）
2023-10-12 ユニットテスト test_modules をパスするよう修正
2023-10-16 明示的メモリリード時のみ rd_mem を 1 にする
2023-10-17 LEDにstack0/1の値を表示する
2023-10-19 低速モードで周辺機器レジスタが読めないバグを修正
2023-10-19 実機でもUART読み取りをサポート
2023-10-19 UART 系バグをシミュレーションで検知しやすくする
2023-10-23 UART 送受信を波形レベルでシミュレート
2023-10-23 EOT受信でシミュレーションが止まらないバグを修正
2023-10-23 uart.py が EOT 受信時に即座に終了する
2023-10-24 ISRの中では演算スタックを整合させる
2023-10-24 実機でUART送信テストが失敗するバグを修正
    UARTから受信したEOTはファイルに記録しない
2023-10-24 カウントダウンタイマをきちんとリセットする
2023-10-24 グローバル変数の初期化ができてないバグを修正
2023-10-24 UART受信割り込みに対応
2023-10-25 減算の構文解析バグを修正
2023-10-25 コンパイラが読めるソースコードサイズを拡大
2023-10-27 UARTのテストを改良
2023-10-29 プログラム転送方式の改良（WIP）
2023-11-13 プログラム転送方式のタイミング設計
2023-11-14 プログラム転送方式の改良（WIP）
    55を受信した際の挙動がテストを通過
2023-11-15 uart_muxのタイミング設計を修正
2023-11-15 プログラム転送モードへ移行する部分の実装
2023-11-15 プログラム転送モードを uart_mux の外部から止める
2023-11-15 uart_mux のテスト高速化
2023-11-15 uart_muxをComProc CPUに組み込む
2023-11-16 UART での命令送信を 1 バイトずつ行う
2024-01-16 send.sh を 1 バイトずつの転送に対応
2024-02-29 8ビットのGPIOを追加
2024-03-04 usbipd-win 4.1.0に対応
2024-03-04 ComProc ADC Extension Rev.1をサポート
2024-03-04 ADC Extension 使用のサンプルコードを追加
2024-03-08 ADCのサンプルプログラムを改良
    読み取った値をLCDにも表示する
2024-03-09 adc.cをリファクタリング
2024-03-21 BRAM プリミティブを使わず BRAM を推論させる
2024-03-21 BRAM の初期値として IPL を埋め込む
2024-03-21 CPUのE2Eテストを修復
    ADC搭載とBRAMの推論化に伴い、テストが壊れていたのを修正する
2024-03-22 初期値無しグローバル変数の RAM 配置バグを修正
2024-03-22 FPGA内蔵ユーザーフラッシュ操作のサポート
2024-03-22 UART 割り込みハンドラの挙動テストプログラムを追加
2024-03-22 IPLで起動回数をフラッシュメモリに記録する
2024-03-25 WSLでUARTドライバがロードされない現象に対応
2024-03-25 CPUのE2Eテストを修復
    ユーザーフラッシュの読み書きサポートに伴いテストできなくなっていたのを修正
2024-03-25 アセンブラにシンボルマップの出力機能を追加
2024-03-25 ビルドスクリプトを改良
2024-03-27 割り込み処理でpopしすぎるバグを修正
2024-03-28 コンパイラ実装のリファクタ（WIP）
2024-03-28 二項演算子のリファクタリング
2024-03-29 二項演算子の修正に関連してテストを修正
2024-03-29 0x200以降のデータメモリへのアクセスのテストケース
2024-04-01 LD/ST の即値を符号無しにする
2024-04-02 src_a に bar を増やす（WIP）
2024-04-02 src_a に bar を増やす
2024-04-02 LD.1などの postfix 方式を止める
2024-04-02 decoder.svのcaseをreturn形式に変更
2024-04-03 ISR命令を無くしてPOP Xを追加
2024-04-03 SRC_xxx マクロを SRCB_xxx に改名
2024-04-03 BARのテストとして4KiBのデータメモリを消費するテストケースを追加
2024-04-03 プログラムの ORIGIN を 0x300→0x4000 へ変更
2024-04-04 compiler/tests のテストケースを修正
    UARTのポート変更や、stack[0]/[1]の入れ替えに対応
2024-04-04 整数定数からなる式をコンパイル時に計算する
2024-04-04 < や == 直後の push 0; neq を無くす
2024-04-05 定数式をアセンブラ内蔵インタプリタを使って計算する
2024-04-08 最新のコンパイラとアセンブラでipl.cをリビルド
2024-04-15 サーボモータ制御プログラム（シンプル制御版）を追加
2024-05-20 Add SPI implementation
2024-05-21 uart.py 実行時に sudo を不要とする
2024-05-22 コンパイラの対応ソースサイズを拡大
2024-05-23 SD カードの初期化に対応
2024-05-28 定数コンパイル時計算のバグを解消
2024-05-28 sim.exe のビルドエラーを解消
2024-05-30 SDカードの容量を取得する
2024-06-03 定数計算のコンパイラテストを現状に合わせて修正
2024-06-03 JOIN 命令を無くし SIGN 命令を新設
2024-06-17 オペランド無しCALLを追加
    コンパイラは関数呼び出しに従来のオペランドありCALLを使うので、
    examples/sdcard.c は関数が遠すぎてアセンブルエラーとなる。要修正。
    [main.c]
2024-06-18 README.mdにCPUボードの写真を追加
2024-06-23 ADCサンプルのUARTに出力するバージョンを追加
2024-07-17 コンパイラは即値無しCALLを使う
    本当は必要な部分のみに限定したいが、簡単のため無条件で即値無しCALLにする
2024-07-17 READ_BL_LEN を表示する
2024-07-18 SDカードのブロック読み込みに対応
2024-07-18 README に情報を追加
    - ComProc まとめページ
    - 主要なファイルの構成
2024-08-02 SDカードのBSを読み取り、MBRかPBRを判定する
2024-08-05 符号拡張命令 EXTS を追加
2024-08-08 構文解析の時点で型を付与する
2024-08-08 コンパイラのユニットテストが失敗するのを修正
2024-08-09 符号無し比較演算 BT, BE を追加
2024-08-09 余分なビットマスクを削減
2024-08-11 build.sh に存在しないファイルを指定した際の誤動作防止
2024-08-19 iverilog 12 でビルドが通るように修正
2024-08-20 for文内で変数定義をサポート
2024-08-20 不完全なプロトタイプ宣言を修正
2024-08-20 関数でfpが変化するときだけcpush/cpopを発行する
2024-08-20 引数が1回しか評価されない場合の最適化
2024-08-20 不必要なpopを削減
2024-08-20 コミット間でビルドし比較するスクリプトを追加
2024-08-20 assembler/main.cをリファクタリング
2024-08-21 後方への CALL は可能な限り即値付き CALL を使う
2024-08-21 mem.svをハーバードアーキテクチャに対応
2024-08-22 アセンブラをハーバードアーキテクチャに対応
2024-08-22 コンパイラが section xxx を出すようにする
2024-08-22 sub fp,n ではなく add fp,n を復活
2024-08-22 db 命令によるデータ配置を 0x100 から行う
2024-08-22 関数の出入り口で cpush/cpop を使わないようにする
    - add fp,x だけ使う
    - ローカル変数のベースアドレスは cstack ではなく fp を使う
2024-08-22 CPU をハーバードアーキテクチャ化
    シミュレーションは動くが、実機の対応は未着手
2024-08-30 実機へのプログラム転送をpmem&dmem分離に対応（WIP）
2024-09-19 send.sh を新しい uart.py に対応
2024-09-19 LED にデバッグ表示
2024-09-19 UART 受信ロジックを修正し多くのテストケースが動作
2024-09-20 dmem の転送ロジックを修正しテストケース全パス
2024-09-20 メモリ関連の信号名を変更
2024-09-24 dmem をボード固有ファイルから MCU 内に移動
2024-09-30 ComProc PC ボード用プロジェクトファイルを生成
2024-10-11 キーボードコントローラを追加
    ComProc PC Rev.1 で LCD 表示サンプルがうまく動作しない
2024-10-11 1引数関数に対する最適化のバグを修正
2024-10-11 ComProc PC 用の LCD デモプログラムを追加
2024-10-12 キーボード入力サンプルを追加
2024-10-13 LCD のバックライトを点灯する
2024-10-15 add configuration file for rev4 board
2024-10-15 CPU Board Rev.4 でビルドを通るようにする
2024-10-17 I2C 駆動回路を追加（WIP）
2024-10-17 i2c_rawモジュールがACK送受信をサポート
2024-10-18 I2C回路とのインタフェースとなるレジスタを追加
2024-10-25 キーボード入力時にLCDのバックライトを点灯する
2024-10-25 ハーバードアーキテクチャに対応した IPL に更新
2024-10-28 LCDバックライトの端子を GPIO として実装
2024-10-30 I2C 回路を実装
2024-10-30 I2C のストップビットを個別に送信する仕組みに変更
2024-11-03 KBCサンプル起動時に音を鳴らす＆LCDバックライト点灯
2024-11-03 KBCサンプルにおいてEnter入力でバッファクリア
2024-11-03 IPLをKBCサンプルの最新版に更新
2024-11-04 CPUシミュレータのビルドエラーを解消
2024-11-05 POP dp を新設 & 即値付き CALL を IP 相対にする
2024-11-05 グローバル領域はDP相対アドレッシングでアクセスする
2024-11-05 簡易な関数ポインタに対応
2024-11-06 PUSH命令が16ビット即値に対応したのでSIGN命令を発効しない
2024-11-06 プログラムメモリへのデータ転送をサポート
2024-11-06 グローバル変数を使うとコンパイルが失敗するバグを修正
2024-11-06 IPLを最新のKBCサンプルに更新
2024-11-06 mainの後で無限ループするかretするか選択可能にする
2024-11-06 not演算の結果が演算スタックに乗らないバグを修正
2024-11-10 UARTでのデータ受信時にbyt=1となるバグを修正
2024-11-11 デバッグ用に追加したコードを削除
2024-11-11 CPU回路がiverilogでビルドできないバグを修正
2024-11-11 ブロック内で変数定義した場合のフレームサイズの計算を修正
2024-11-12 論理否定（!）演算子を追加
2024-11-12 SDカードからアプリを読み取って実行する
2024-11-12 SDカードから読み取ったアプリの実行結果表示のバグ修正
2024-11-22 MSMP通信プロトコルをサポート
2024-11-23 割り込みを使ってMSMP受信ロジックを改善
2024-11-23 データが空のフレーム復帰信号に対するバグ修正
2024-11-23 msmp.cをUTF-8からSJISに変換（半角カタカナのため）
2024-11-23 シミュレーションのビルドエラーを解消
2024-11-23 MSMPソフト改良＆\x23形式のエスケープに対応
2024-11-24 ComProc PC の ADC 変換バグを修正
    [main.sv]
2024-11-24 MSMP で ADC を取得する機能を追加
2024-11-24 先頭がHのメッセージを受け取ったら挨拶を返す
2024-11-24 MSMPのメッセージ種別の表示方法を微修正
2024-11-26 実行ファイル形式を導入
    - .data と .text を同一ファイルに収めた実行ファイル形式を新たに定める
    - 命令メモリを 8KW から 16KW に拡大
2024-11-26 sdcard.c に ls, ld, run コマンドを追加
2024-11-26 MSMPサンプルアプリがapp modeで動くように修正
    逆にos modeでは動かなくなる
    [main.c]
2024-11-26 MSMPサンプルアプリにexitコマンドを追加
2024-11-27 コンパイラバグ修正
    - 割り込みハンドラ以外でも push/pop の対応を取る
    - `if (f() >= 0)` のような場面で f() の呼び出し前後で演算スタック
    が整合している必要があるため
    - ret 直前の add fp,N を整合させる
    [main.c]
2024-11-27 sdcard.c でアプリ名のみを入れた場合にそのアプリを起動する
2024-11-27 sdcard.c に sdinfo コマンドを追加
2024-11-28 IPLをsdcard.cへと更新
2024-11-28 先頭にpmem_lenとdmem_lenを自動的に挿入する
2024-11-28 FPGAオンボードスイッチの1つをストップ用ボタンとして活用
2024-11-30 sdcard.cにcatコマンドを追加
2024-11-30 Shift押下時に記号を入力する
2024-11-30 アプリのmain関数に構成情報ベクトルを渡す
2024-11-30 IPLを最新のsdcard.cに更新
2024-11-30 msmp.c で送信間隔を動的に変更できるようにする
2024-12-07 ComProc PC rev.1 の回路図を追加
2024-12-09 ComProcの各コンポーネントの関連と名前付けを説明
2024-12-12 uart_command.c を ComProc PC での動作に対応させる
2024-12-12 uart.pyでバイト列受信時に1バイト毎にフラッシュする
2024-12-12 アプリの先頭に pmem_len & dmem_len を自動補完する
2024-12-18 include をサポート、良く使う定義をヘッダファイル化
2024-12-18 UART3 を追加 & sdcard.c が UART3 を使って入出力する
2024-12-18 関数とグローバル変数の後定義に対応
2024-12-18 sdcard.cのビルドエラーを修正
2024-12-18 コンパイルエラー時に空ファイルを生成しない
2024-12-18 uasmがpmem hexをstdoutに出力しないようにする
2024-12-18 sdcard.cをコピーしてDOSの初期版とする
2024-12-18 配列の初期化をサポート
2024-12-18 コンパイラの単体テストを現状に合わせ修正
2024-12-18 配列アクセスの最適化
2024-12-18 追加し忘れていたコンパイラ単体テストを追加
2024-12-18 変数のコード生成をリファクタ
2024-12-18 無駄な間接参照を減らす
2024-12-18 ポインタの添え字アクセスの最適化
2024-12-18 DOS にシステムコールの仕組みを追加
2024-12-18 IPLを最新のDOSに更新
2024-12-18 diff-by-commitsの引数でコミットIDを指定する
2024-12-25 swtich-case 文をサポート
2024-12-26 defaultラベルがある場合に余分なラベルを出力しない
2024-12-26 文字列をUARTに出力するシステムコールを追加
2025-01-06 制御構文で余分な値がスタックに積まれたままになるバグを修正
2025-01-06 switch文でdefaultラベルとbreakを使った場合のバグを修正
2025-01-06 戻り値無しの関数呼び出しで余分にpopされるバグを修正
2025-01-08 ポインタインクリメントのアドレス加算量のバグ修正
2025-01-16 配列の初期値が足りないときは残りを0で初期化する
2025-01-16 .dataのラベルが1つもない場合に.dataが0バイトになるバグを修正
2026-08-22 ボード動作確認のための回路を追加
